MrAJB/Heat-Controller/Documentation/Images/Side-by-side editor.jpg

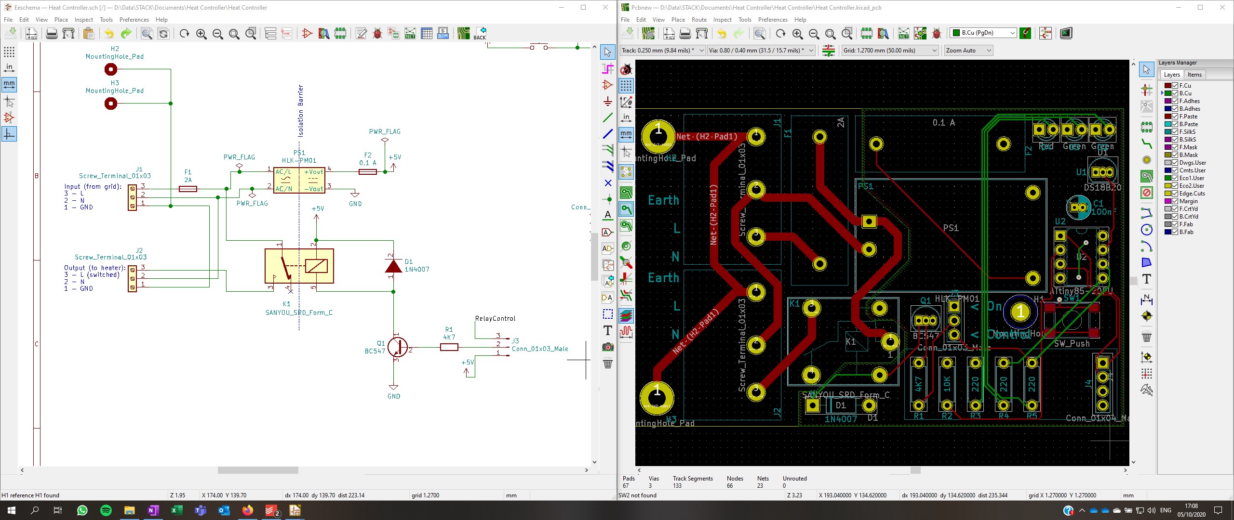
Documentation/Images/Side-by-side editor.jpg
