MrAJB/Heat-Controller/Documentation/Images/PCB layout.jpg

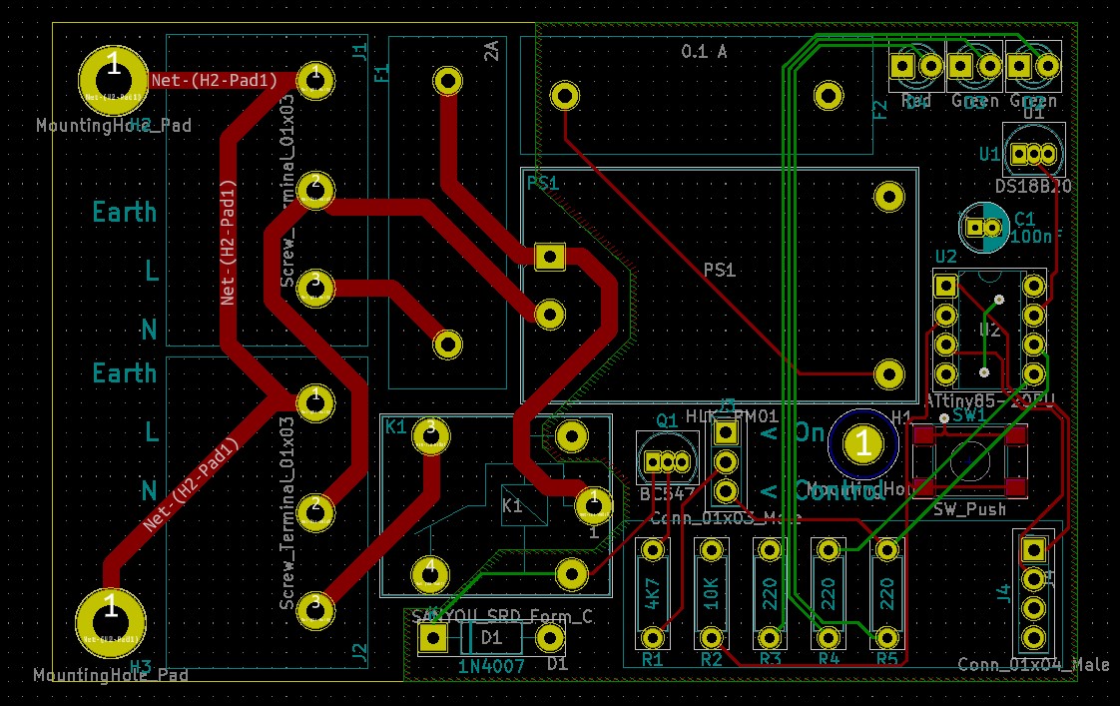
Documentation/Images/PCB layout.jpg
