MrAJB/Heat-Controller/README.md

# Heat Controller Project
Repo for the heat controller I am developing in my spare time. The goal is to develop some simple firmware and hardware to control a heating element. 

Feel free to look around and re-use (pieces of) this project!
