MrAJB/Heat-Controller/Documentation/Images/3D Preview.png

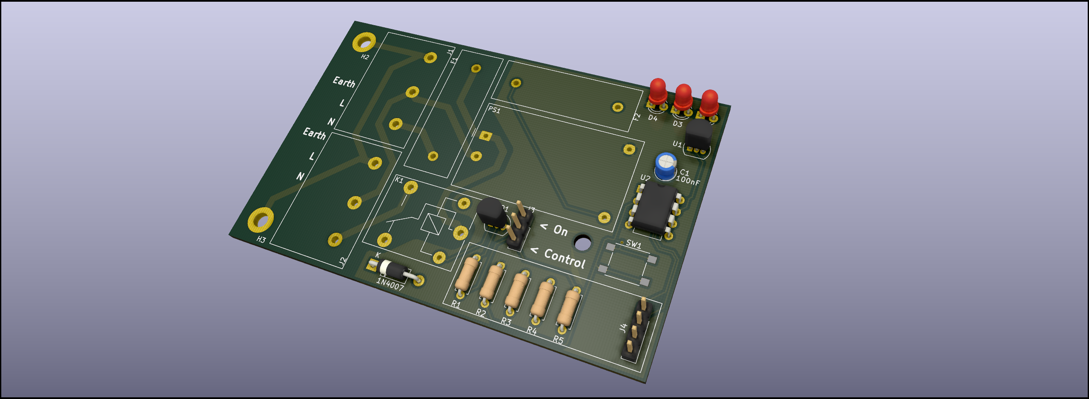
Documentation/Images/3D Preview.png
