MrAJB/Heat-Controller/Documentation/Images/Schematics.jpg

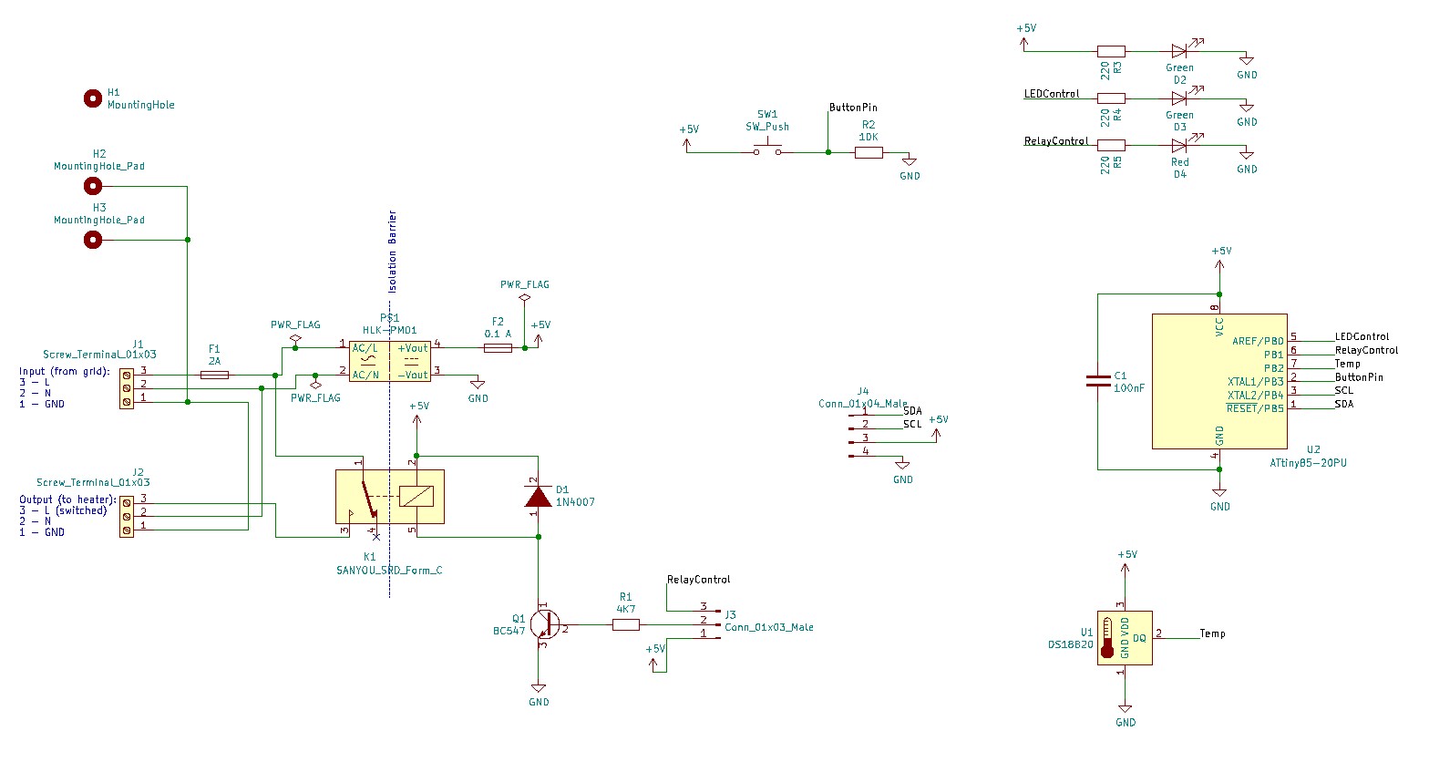
Documentation/Images/Schematics.jpg
