MrAJB/Heat-Controller/CAD/MainAssembly.SLDASM

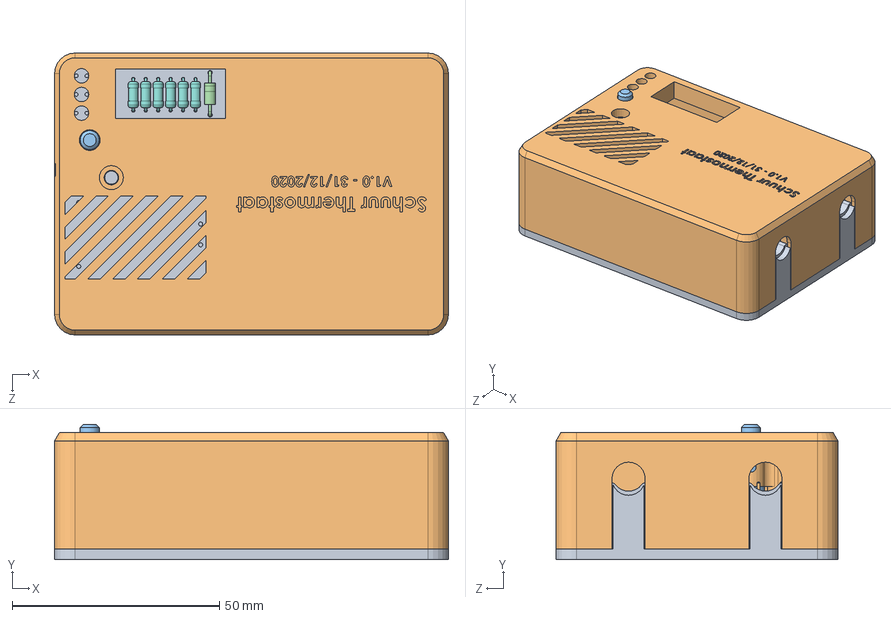
[picture p5: CAD file, 2021-01-02]
CAD/MainAssembly.SLDASM
95.0 x 32.6 x 68.0 mm
Bottom
Top
Button
