MrAJB/Heat-Controller/CAD/PCB/PCB.SLDASM

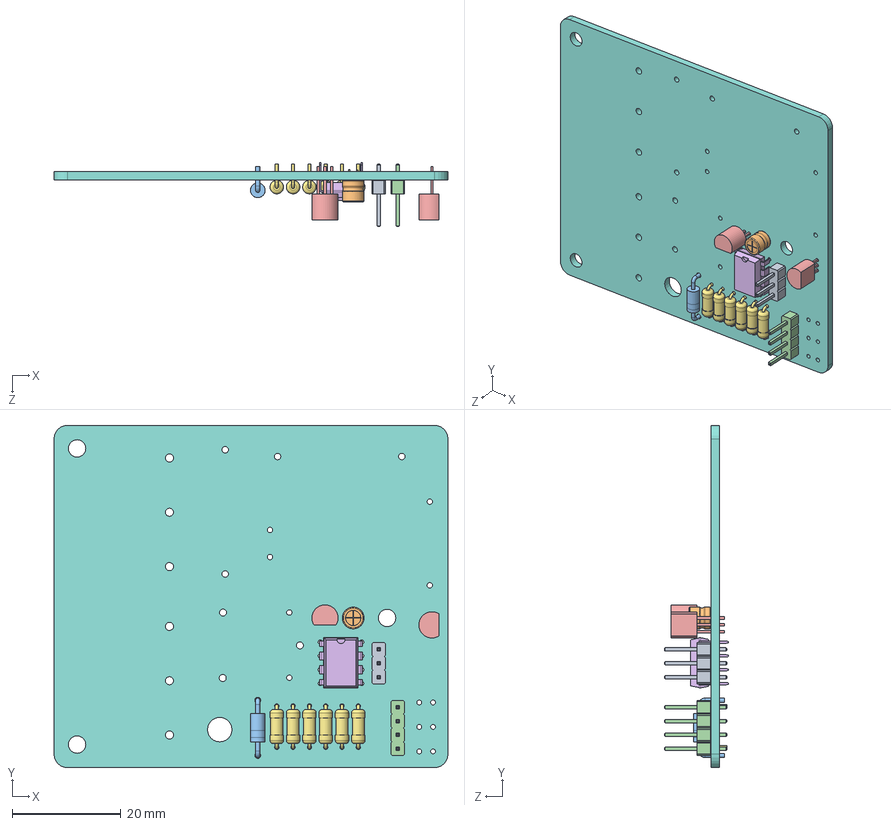
[picture p6: CAD file, 2021-01-01]
CAD/PCB/PCB.SLDASM
72.5 x 63.0 x 11.8 mm
