MrAJB/Heat-Controller/CAD/Button.SLDPRT

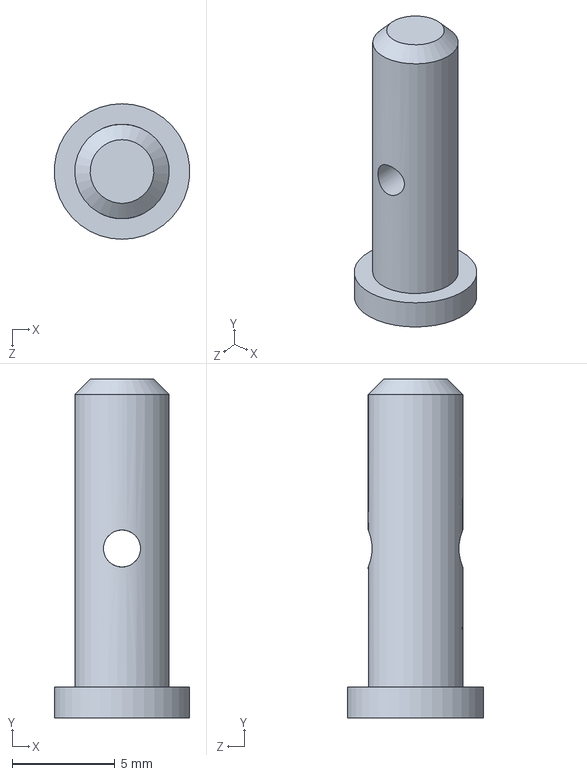
[picture p7: CAD file, 2021-01-02]
CAD/Button.SLDPRT
6.58 x 16.5 x 6.60 mm
