MrAJB/Heat-Controller/CAD/Bottom.SLDPRT

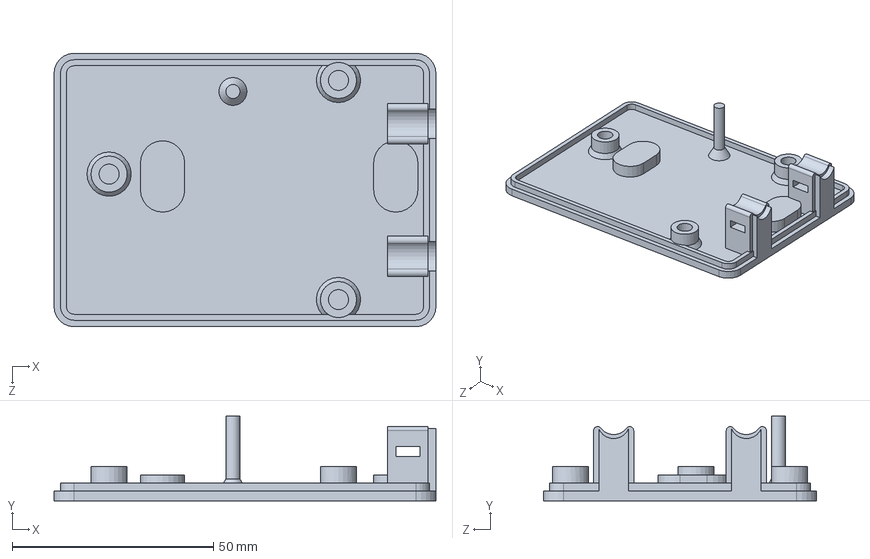
[picture p8: CAD file, 2021-01-01]
CAD/Bottom.SLDPRT
95.0 x 21.1 x 68.0 mm
