MrAJB/Heat-Controller/CAD/Top.SLDPRT

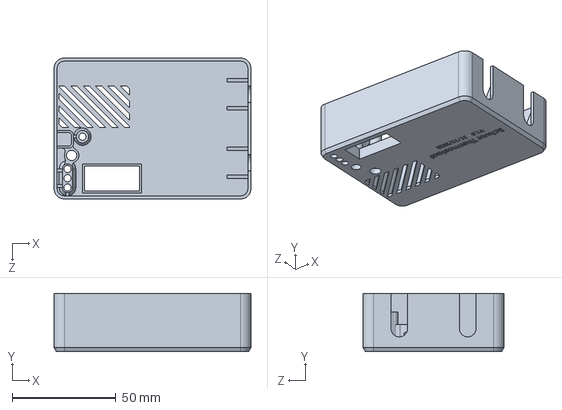
[picture p9: CAD file, 2021-01-01]
CAD/Top.SLDPRT
95.0 x 28.1 x 68.0 mm
