MrAJB/Heat-Controller/CAD/PCB/Heat Controller.step

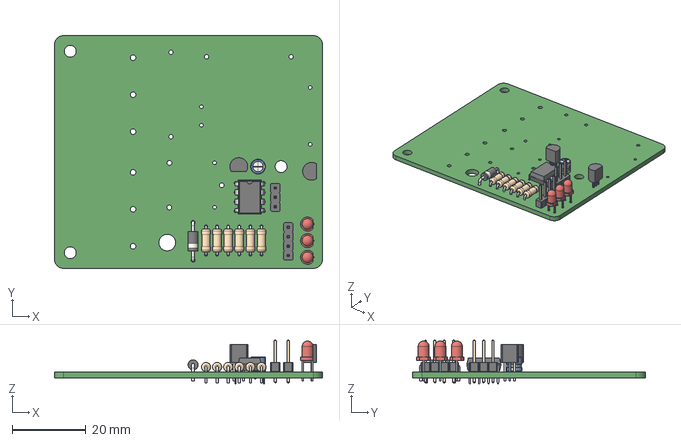
[picture p10: CAD file, 2020-11-02]
CAD/PCB/Heat Controller.step
72.5 x 63.0 x 11.8 mm
