MrAJB/Heat-Controller/(list of files, cad)

Other CAD files:
CAD/PCB/R_Axial_DIN0207_L6.3mm_D2.5mm_P7.62mm_Horizontal.sldasm
CAD/PCB/DIP-8_W7.62mm.sldasm
CAD/PCB/TO-92_Inline.sldasm
CAD/PCB/PinHeader_1x04_P2.54mm_Vertical.sldasm
CAD/PCB/CP_Radial_D4.0mm_P1.50mm.sldasm
CAD/PCB/PinHeader_1x03_P2.54mm_Vertical.sldasm
CAD/PCB/LED_D3.0mm.sldasm
CAD/PCB/D_DO-41_SOD81_P10.16mm_Horizontal.sldasm
CAD/PCB/SOLID_5.sldprt
CAD/PCB/SOLID_3.sldprt
CAD/MasterSketch.SLDPRT
CAD/PCB/COMPOUND.sldprt
CAD/PCB/SOLID_7.sldprt
CAD/PCB/SOLID_6.sldprt
CAD/PCB/SOLID_8.sldprt
CAD/PCB/SOLID_4.sldprt
CAD/PCB/SOLID_2.sldprt
CAD/PCB/SOLID.sldprt
CAD/PCB/PCB.SLDPRT
CAD/STL/Bottom.STL
CAD/STL/Button.STL
CAD/STL/ScrewGuide.STL
CAD/STL/Top.STL
CAD/ScrewGuide.SLDPRT
