MrAJB/Heat-Controller/Hardware/Heat_Controller_Schematic_Rev2.pdf

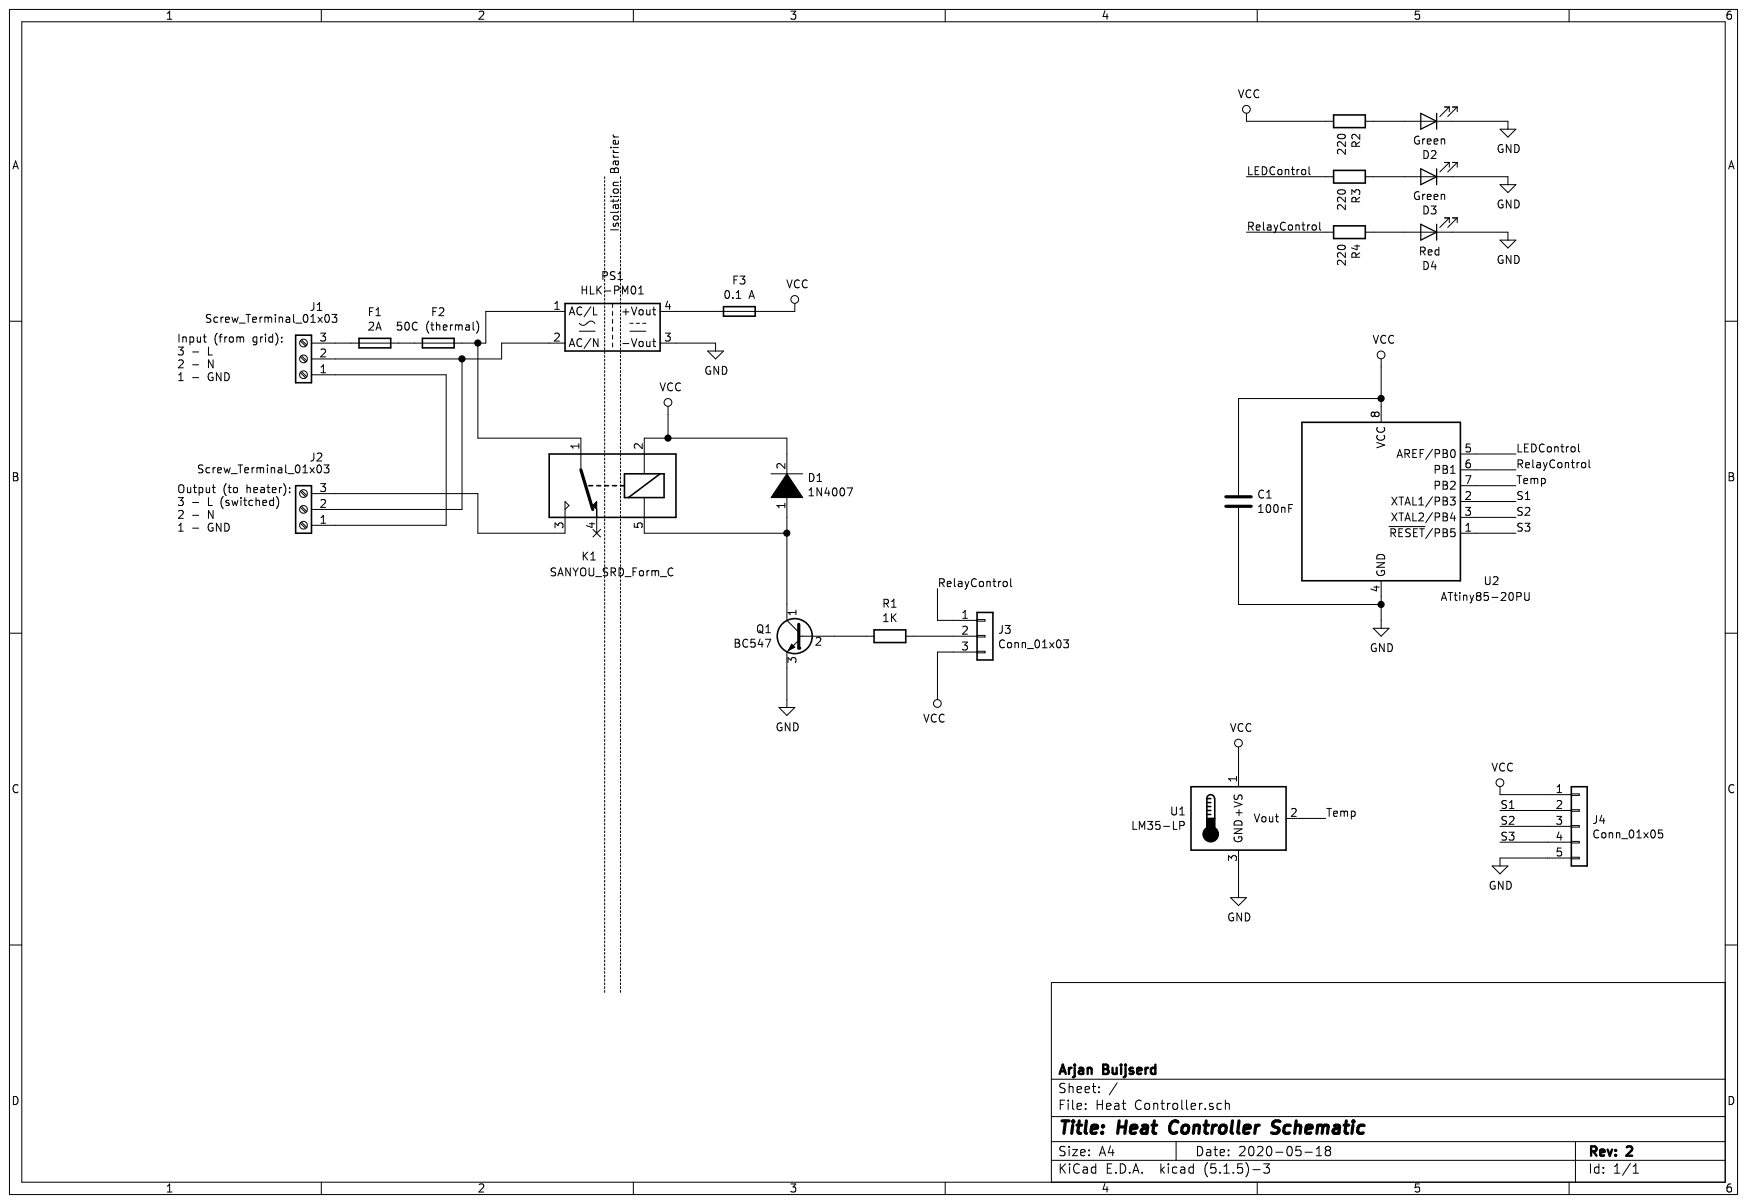
[picture p11: page 1]
