MrAJB/Heat-Controller/Hardware/Heat_Controller_Schematic_Rev1.pdf

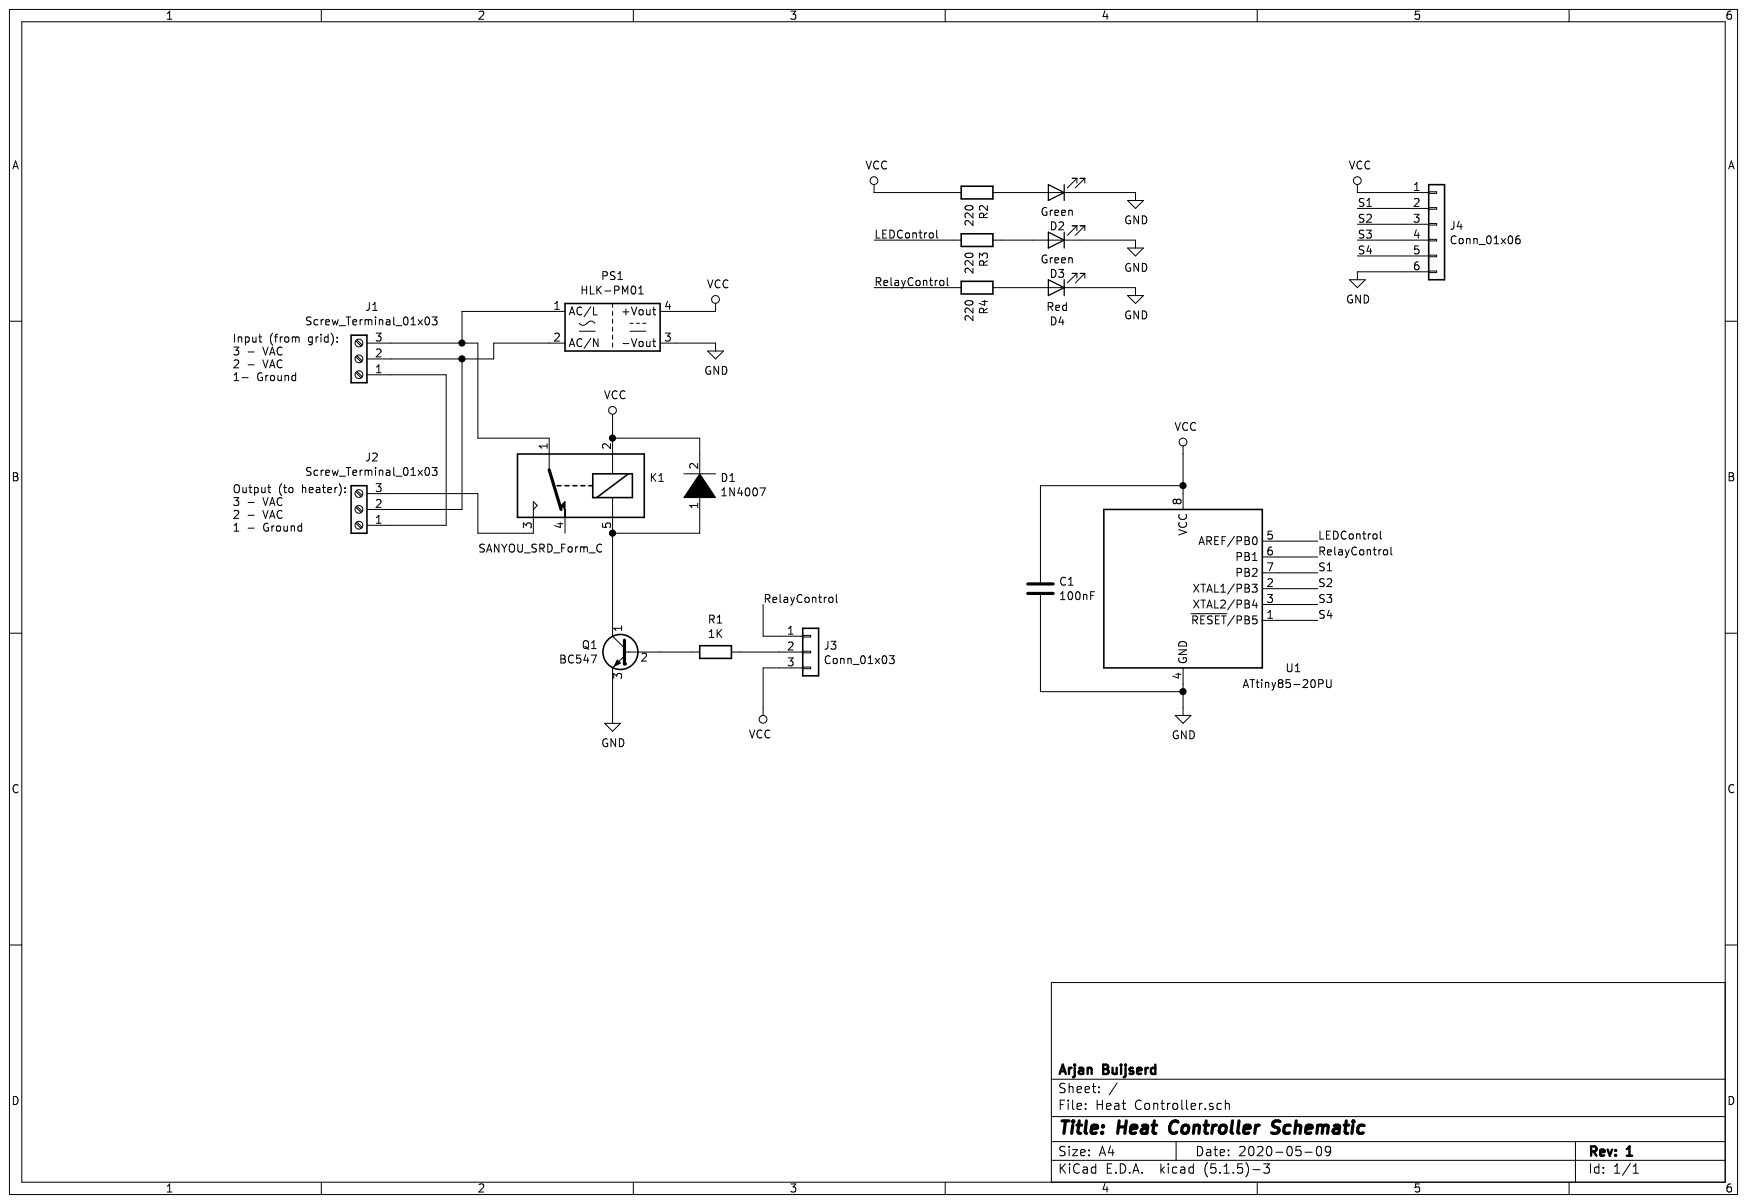
[picture p12: page 1]
