MrAJB/Heat-Controller/Hardware/Heat Controller.kicad_pcb

## KiCad design Hardware/Heat Controller.kicad_pcb (2020-11-02)

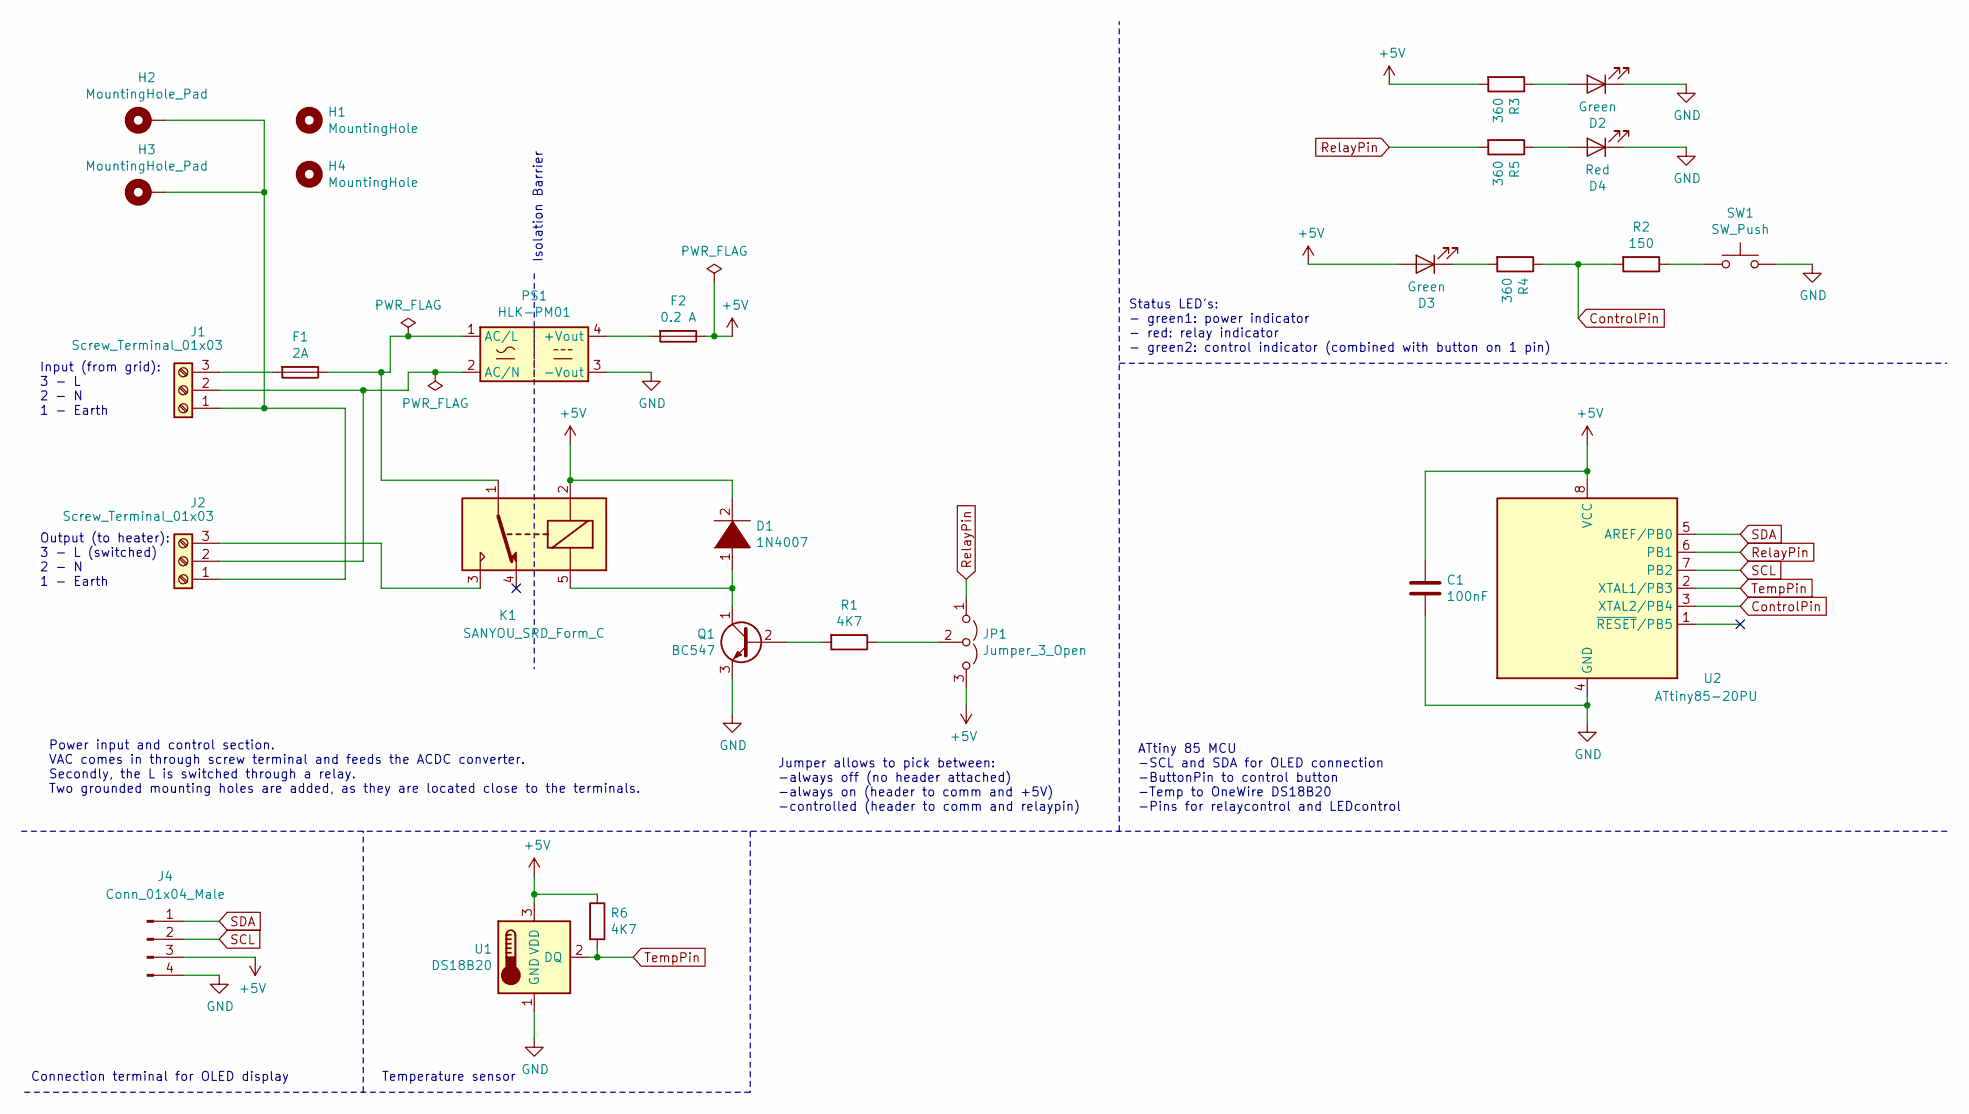
[picture p13: schematic Heat Controller.sch, Heat Controller Schematic]

Parts:
C1: 100nF; CP_Radial_D4.0mm_P1.50mm
D1: 1N4007; D_DO-41_SOD81_P10.16mm_Horizontal
D2, D3: Green; LED_D3.0mm
D4: Red; LED_D3.0mm
F1: 2A; Fuse_Holder_04x20
F2: 0.2 A; Fuse_Holder_04x20
H1: MountingHole; MountingHole_3.2mm_M3_ISO7380
H2, H3: MountingHole_Pad; MountingHole_3.2mm_M3_ISO7380_Pad
H4: MountingHole; MountingHole_4.5mm
J1, J2: Screw_Terminal_01x03; ScrewTerminal_01x03_HeavyDuty
J4: Conn_01x04_Male; PinHeader_1x04_P2.54mm_Vertical
JP1: Jumper_3_Open; PinHeader_1x03_P2.54mm_Vertical
K1: SANYOU_SRD_Form_C; Relay_SPDT_SANYOU_SRD_Series_Form_C
PS1: HLK-PM01; Converter_ACDC_HiLink_HLK-PMxx
Q1: BC547; TO-92_Inline
R1, R6: 4K7; R_Axial_DIN0207_L6.3mm_D2.5mm_P7.62mm_Horizontal
R2: 150; R_Axial_DIN0207_L6.3mm_D2.5mm_P7.62mm_Horizontal
R3, R4, R5: 360; R_Axial_DIN0207_L6.3mm_D2.5mm_P7.62mm_Horizontal
SW1: SW_Push; SW_Push_1P1T_NO_6x6mm_H9.5mm
U1: DS18B20; TO-92_Inline
U2: ATtiny85-20PU; DIP-8_W7.62mm

Connections:
+5V: C1.1, D1.2 (A), D3.2 (A), F2.1, J4.3, JP1.3 (B), K1.2, R3.2, R6.1, U1.3 (VDD), U2.8 (VCC)
ControlPin: R2.2, R4.1, U2.3 (XTAL2/PB4)
GND: C1.2, D2.1 (K), D4.1 (K), J4.4, PS1.3 (-Vout), Q1.3 (E), SW1.2, U1.1 (GND), U2.4 (GND)
unnamed: D1.1 (K), K1.5, Q1.1 (C)
unnamed: D2.2 (A), R3.1
unnamed: D3.1 (K), R4.2
unnamed: D4.2 (A), R5.1
unnamed: F1.1, K1.1, PS1.1 (AC/L)
unnamed: F1.2, J1.3
unnamed: F2.2, PS1.4 (+Vout)
unnamed: H2.1, H3.1, J1.1, J2.1
unnamed: J1.2, J2.2, PS1.2 (AC/N)
unnamed: J2.3, K1.3
unnamed: JP1.2 (C), R1.1
unnamed: Q1.2 (B), R1.2
unnamed: R2.1, SW1.1
RelayPin: JP1.1 (A), R5.2, U2.6 (PB1)
SCL: J4.2, U2.7 (PB2)
SDA: J4.1, U2.5 (AREF/PB0)
TempPin: R6.2, U1.2 (DQ), U2.2 (XTAL1/PB3)

Notes on the sheet:
Input (from grid): 3 - L 2 - N 1 - Earth
Output (to heater): 3 - L (switched) 2 - N 1 - Earth
Isolation Barrier
Power input and control section. VAC comes in through screw terminal and feeds the ACDC converter. Secondly, the L is switched through a relay. Two grounded mounting holes are added, as they are located close to the terminals.
Jumper allows to pick between: -always off (no header attached) -always on (header to comm and +5V) -controlled (header to comm and relaypin)
Connection terminal for OLED display
Temperature sensor
Status LED's: - green1: power indicator - red: relay indicator - green2: control indicator (combined with button on 1 pin)
ATtiny 85 MCU -SCL and SDA for OLED connection -ButtonPin to control button -Temp to OneWire DS18B20 -Pins for relaycontrol and LEDcontrol

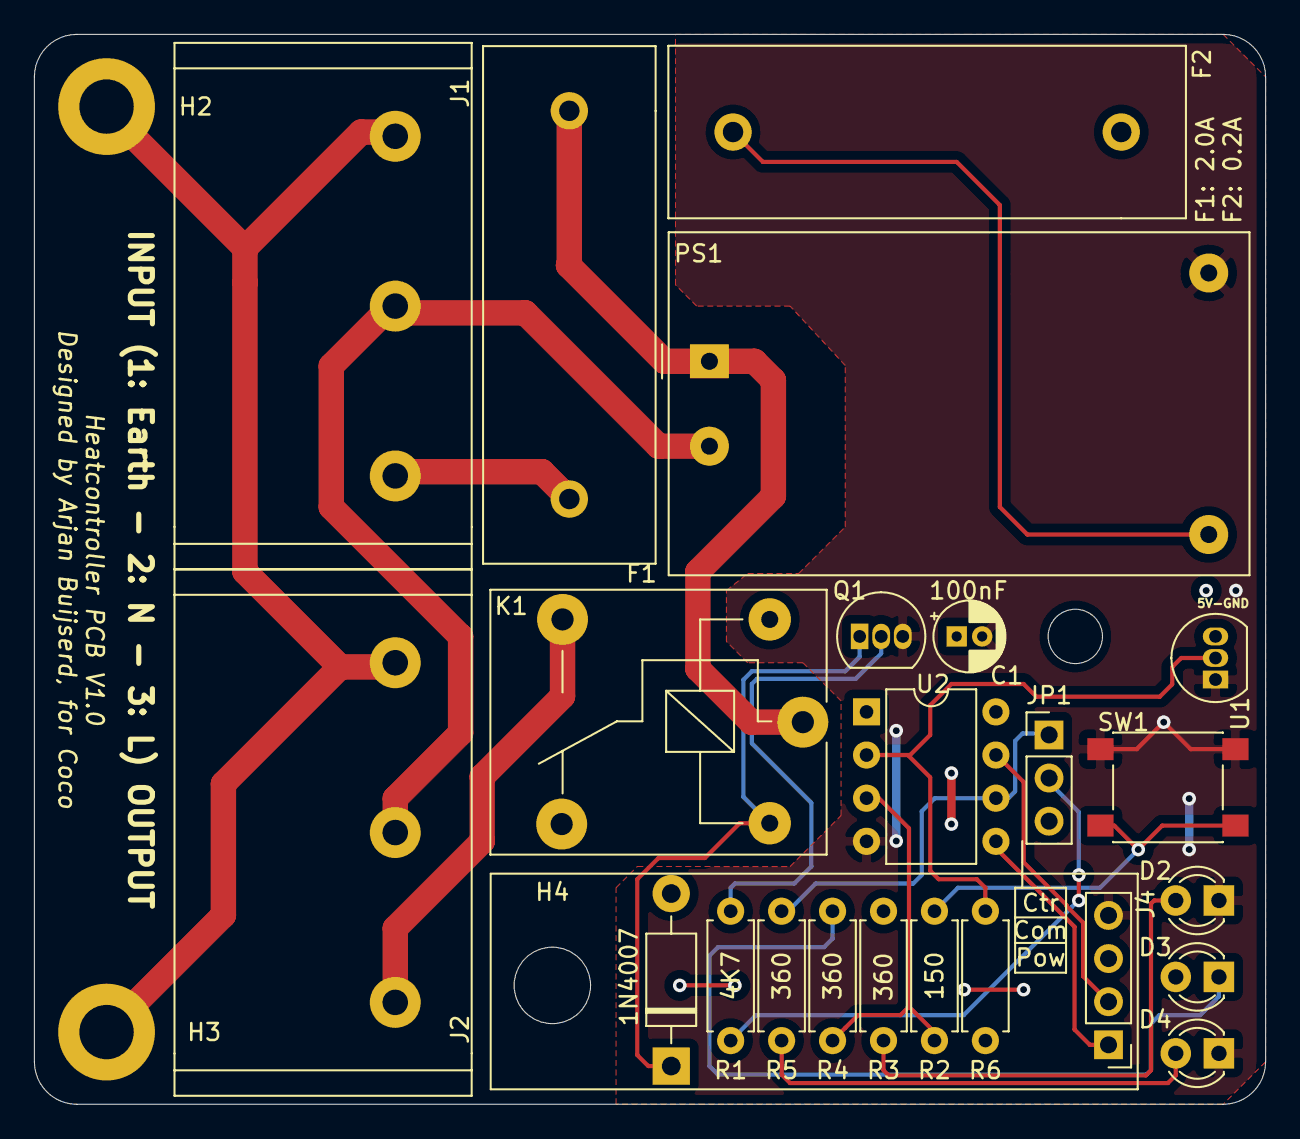
[picture p14: board Heat Controller.kicad_pcb from above]

Board: 2 copper layers, 72.5 x 63.0 mm, 27 parts (0 on the bottom side), 20 nets.
