MrAJB/Heat-Controller/(threads)

Thread 1 (2020-10-11):

Traces length for double busses (e.g. I2C)

Kartoffel124, 2020-10-11:
Check if trace length for double busses should be equalised.

Kartoffel124, 2020-11-02:
I2C is non-differential, so not of relevance.

Closed 2020-11-02.

Thread 2 (2020-10-11):

Switch VCC to OLED on using transistor

Kartoffel124, 2020-10-11:
Research if it is possible to switch VCC to the OLED on just before using with a transistor, shutting the OLED down again after use. Might result in connectivity issues?

Kartoffel124, 2020-10-25:
Not needed, OLED library supports turning the display on and off.

Closed 2020-10-25.

Thread 4 (2020-10-11):

OLED display terminal is flipped

Kartoffel124, 2020-10-11:
The terminal currently has the SDA pin facing to the upper side, whereas this should be the GND pin to accomodate for proper placement.

Kartoffel124, 2020-11-02:
Resolved!

Closed 2020-11-02.

Thread 5 (2020-10-11):

Check F1 value

Kartoffel124, 2020-10-11:
2A might be a bit tricky for 500W applications, check which ratings are available and pick one that's a bit higher.

Kartoffel124, 2020-10-11:
Also make sure the writings on the silkscreen match the actual selected fuse rating

Kartoffel124, 2020-11-02:
I don't have any other suited value available at the moment, might need to order if it becomes an issue.

Thread 9 (2020-10-26):

PB5 not to be used on ATtiny85

Kartoffel124, 2020-10-26:
Multiple sources confirm that it is preferred to stay away from using the PB5 pin for I/O. To make up for this 'lost pin', changed to be implemented:

- [x] Remove all interrupt-related code
- [x] Connect both the control LED and the button to the same pin in KiCad: update the schematic and routing accordingly (example: https://forum.arduino.cc/index.php?topic=439838.msg3030824#new)
- [x] Test new functionality

Kartoffel124, 2020-11-02:
Tested, this feature works perfectly fine for this application.

Closed 2020-11-02.

Thread 11 (2020-10-28):

Display support hole in PCB

Kartoffel124, 2020-10-28:
Add a hole in the PCB to allow for a support at the other end of the display. Nothing fancy needed, just a whole through which a 3D-printed support can fit.

Kartoffel124, 2020-11-02:
Done!

Closed 2020-11-02.

Thread 15 (2020-11-11):

Increase hole size for fuse holders and AC terminals

MrAJB, 2020-11-11:
Currently the fit is very tight

Thread 16 (2020-11-11):

Increase LED resistor values

MrAJB, 2020-11-11:
LEDs are currently insanely bright, tested with different versions (5mm VS 3mm), so test again and find better value to not go blind.

MrAJB, 2020-11-11:
Replaced the green LED resistors with a whopping 10K! Red was fine. Still to be implemented in the PCB design.

Thread 17 (2020-11-11):

Resistor value R6 is missing

MrAJB, 2020-11-11:
Add to silkscreen

Thread 18 (2020-11-11):

Diode polarity is reversed

MrAJB, 2020-11-11:
Soldered is reverse on the PCB, but should be fixed.

See this thread too: https://www.reddit.com/r/KiCad/comments/ca6co8/is_diode_symbol_reversed_in_kicad/

Thread 20 (2020-11-28):

Transistor collector and emittor are reversed

MrAJB, 2020-11-28:
The transistor is reversed, meaning that the collector is connected to GND and the emittor to the relay coil. Solved for now by re-soldering the transistor to the bottom, but should be fixed on the PCB.

Thread 23 (2020-11-28):

Add hole to button

MrAJB, 2020-11-28:
Add a small hole to the button to allow for a small piece of filament to lock the button in place

MrAJB, 2021-01-01:
Implemented in #24

Closed 2021-01-01.
