MrAJB/Heat-Controller/Firmware/main/error.ino

// Helper functions for error handling

// Error mode to indicate that the temperature sensor is not found
void sensor_error(){
    while(true){
        //Turn heater off
        heater_off();

        // Blink the LED to indicate an error
        control_LED_blink(250);

        //TODO - Every now and then, check if the error is resolved and break the loop
    }
}

// Error mode to show temperatures are out of range
void temp_error(){
    while(true){
        //Turn heater off
        heater_off();

        // Blink the LED to indicate an error
        control_LED_blink(1000);

        //TODO - Every now and then, check if the error is resolved and break the loop
    }
}
