MrAJB/Heat-Controller/(commit log)

2020-10-11 Added schematic files from local folder.
    [Heat Controller.kicad_pcb, Heat Controller.sch]
2020-10-11 Updated PCB according to schematic change.
    Added 4K7 resistor for one-wire signal line. Updated connections to ATtiny85 to work with I2C OLED display. To be rerouted.
    [Heat Controller.kicad_pcb]
2020-10-11 Remplaced normal terminal for jumper
    [Heat Controller.sch]
2020-10-11 Minor changes
    [Heat Controller.kicad_pcb]
2020-10-21 Moved Arduino file in main folder
2020-10-23 Implemented code for temperature readings
2020-10-25 Tested temp sensor. Ran into memory issues.
    [display.ino, main.ino, temperature.ino]
2020-10-26 Found interrupt example
2020-10-26 Temperature reading and checking functionality
2020-10-26 Finished LED helper functions
2020-10-26 Implemented LED blinks for debugging
2020-10-28 No longer using interrupts
2020-10-28 Invert control LED, test function to read switch
    Used 360 ohm R for LED, 150 ohm R for button.
    [led.ino, main.ino]
2020-10-28 Test vias for ADCD converter
    [Heat Controller.kicad_pcb]
2020-11-02 Fixed multiple TODOs, implemented main loop
    [display.ino, led.ino, main.ino, temperature.ino]
2020-11-02 Prepared PCB for ordering
    [Heat Controller-B_Cu.gbl, Heat Controller-B_Mask.gbs, Heat Controller-B_Paste.gbp, Heat Controller-B_SilkS.gbo, Heat Controller-Edge_Cuts.gm1, Heat Controller-F_Cu.gtl, Heat Controller-F_Mask.gts, Heat Controller-F_Paste.gtp]
2020-11-02 Added STEP file for case design
    [Heat Controller.step]
2020-11-12 Display temperatures on display
2020-11-23 Minor progression
    [Bottom.SLDPRT, COMPOUND.sldprt, CP_Radial_D4.0mm_P1.50mm.sldasm, DIP-8_W7.62mm.sldasm, D_DO-41_SOD81_P10.16mm_Horizontal.sldasm, Heat Controller.step, LED_D3.0mm.sldasm, MainAssembly.SLDASM]
2020-11-28 Finished all parts for first print
    [Bottom.SLDPRT, Bottom.STL, Button.SLDPRT, Button.STL, LED_D3.0mm.sldasm, MainAssembly.SLDASM, PCB.SLDASM, SOLID_4.sldprt]
2020-11-28 Added runtime display
    Still contains bug, integers are not displayed
    [display.ino, main.ino]
2020-11-28 Set correct temp values and fixed display issue
    [display.ino, main.ino]
2020-11-28 Update runtime straight after reset
    [main.ino]
2020-11-28 Relay transistor datasheet
2020-11-28 Resolved first issues after printing bottom
    [Bottom.SLDPRT, Bottom.STL, MainAssembly.SLDASM, Top.SLDPRT, Top.STL]
2020-12-30 Resolved final issues
    [Bottom.SLDPRT, MainAssembly.SLDASM, Top.SLDPRT]
2020-12-30 Generated STLs for printing
    [Bottom.STL, Button.SLDPRT, MainAssembly.SLDASM, Top.SLDPRT, Top.STL]
2020-12-30 Minor changes/fixes
    [Button.SLDPRT, Button.STL, MainAssembly.SLDASM, ScrewGuide.SLDPRT, ScrewGuide.STL, Top.SLDPRT, Top.STL]
2020-12-31 Updated date in top part
    [MainAssembly.SLDASM, Top.SLDPRT, Top.STL]
2021-01-01 Iterated display slot dimensions
    [MainAssembly.SLDASM, Top.SLDPRT, Top.STL]
2021-01-02 Updated button
    Modified hole position and increased length a bit.
    [Button.SLDPRT, Button.STL, MainAssembly.SLDASM]
